ubc-biztech/bizbot-firmware/hardware/pcb-export/Untitled.kicad_pcb

## KiCad design hardware/pcb-export/Untitled.kicad_pcb (2026-11-02)

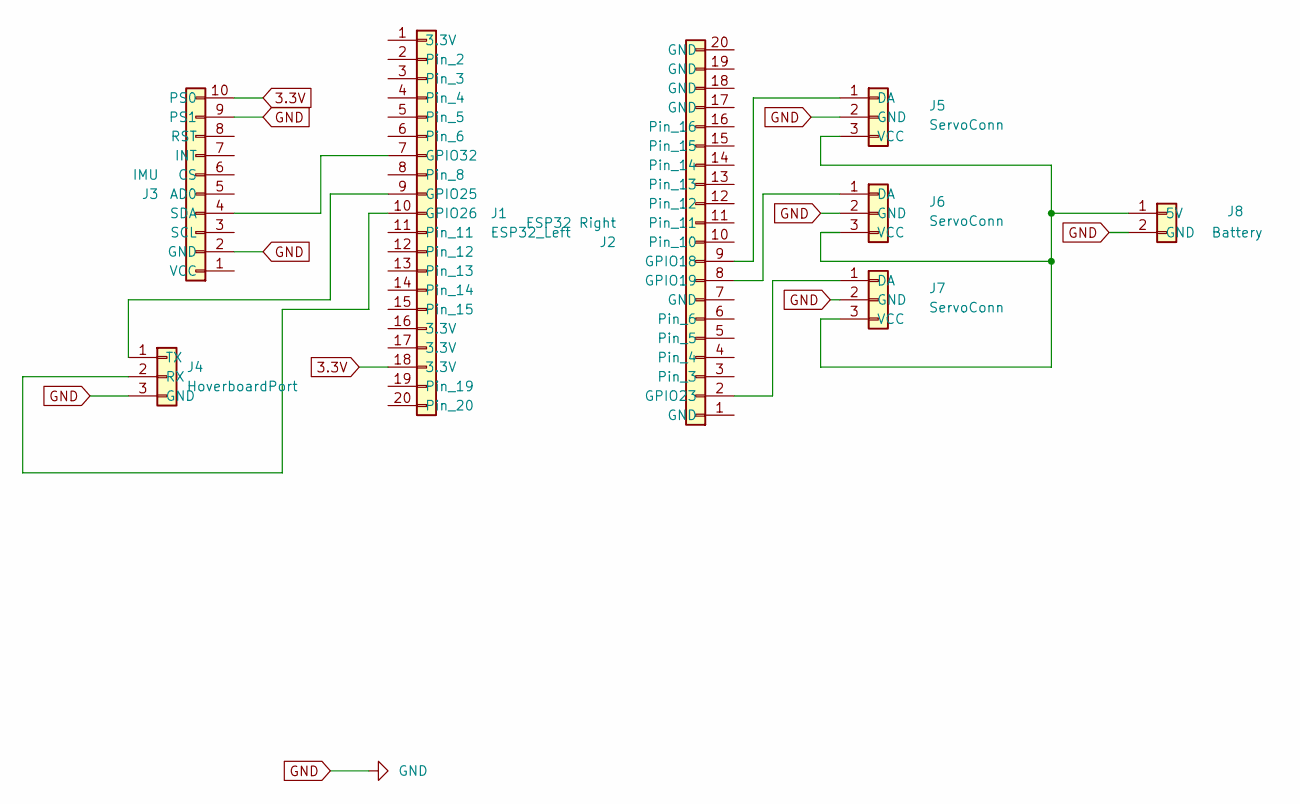
[picture p1: schematic Untitled.kicad_sch]

Parts:
J1: ESP32_Left; PinHeader_1x20_P2.54mm_Vertical
J2: ESP32 Right; PinHeader_1x20_P2.54mm_Vertical
J3: IMU; PinHeader_1x10_P2.54mm_Vertical
J4: HoverboardPort; PinHeader_1x03_P2.54mm_Vertical
J5, J6, J7: ServoConn; PinHeader_1x03_P2.54mm_Vertical
J8: Battery; PinHeader_1x02_P2.54mm_Vertical

Connections:
3.3V: J1.18 (3.3V), J3.10 (PS0)
GND: J3.2 (GND), J3.9 (PS1), J4.3 (GND), J5.2 (GND), J6.2 (GND), J7.2 (GND), J8.2 (GND)
unnamed: J1.9 (GPIO25), J4.1 (TX)
unnamed: J1.10 (GPIO26), J4.2 (RX)
unnamed: J1.7 (GPIO32), J3.4 (SDA)
unnamed: J2.9 (GPIO18), J5.1 (DA)
unnamed: J2.8 (GPIO19), J6.1 (DA)
unnamed: J2.2 (GPIO23), J7.1 (DA)
unnamed: J5.3 (VCC), J6.3 (VCC), J7.3 (VCC), J8.1 (5V)

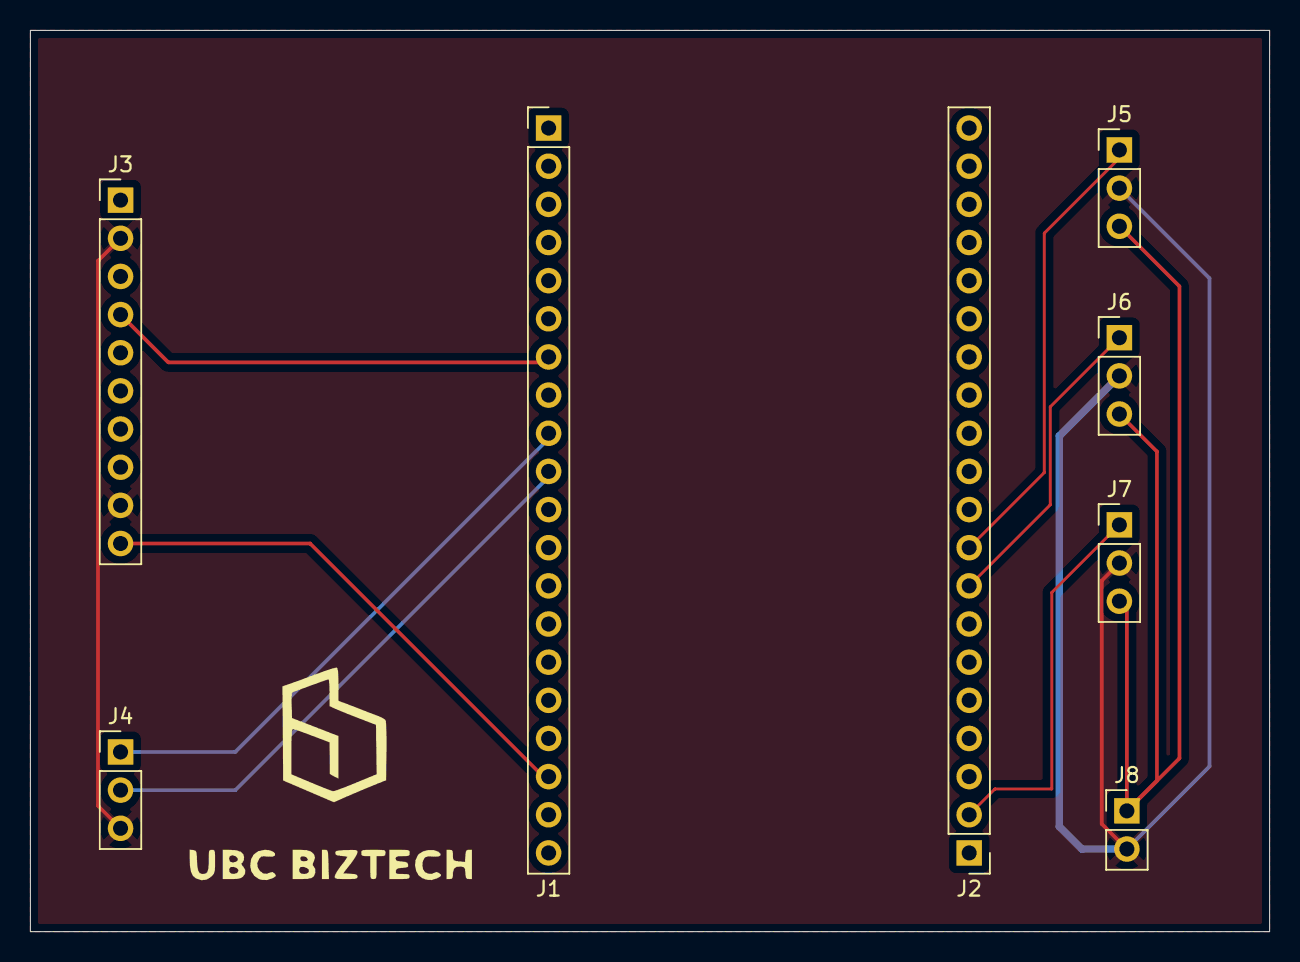
[picture p2: board Untitled.kicad_pcb from above]

Board: 2 copper layers, 82.5 x 60.0 mm, 8 parts (0 on the bottom side), 9 nets.
