ubc-biztech/bizbot-firmware/Electrical/Untitled.kicad_sch

## KiCad design Electrical/Untitled.kicad_sch (2026-10-30)

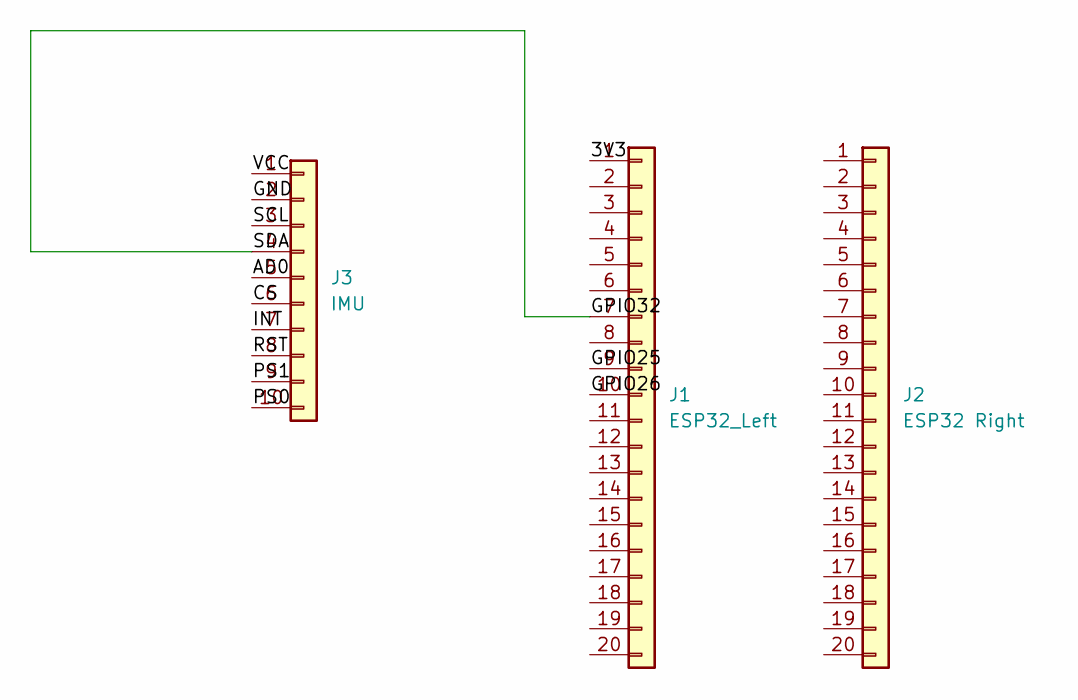
[picture p3: schematic Untitled.kicad_sch]

Parts:
J1: ESP32_Left
J2: ESP32 Right
J3: IMU

Connections:
3V3: J1.1
AD0: J3.5
CS: J3.6
GND: J3.2
GPIO25: J1.9
GPIO26: J1.10
GPIO32: J1.7, J3.4
INT: J3.7
PS0: J3.10
PS1: J3.9
RST: J3.8
SCL: J3.3
VCC: J3.1
