ubc-biztech/bizbot-firmware/Untitled/bizbotPCB.kicad_sch

## KiCad design Untitled/bizbotPCB.kicad_sch (2026-10-30)

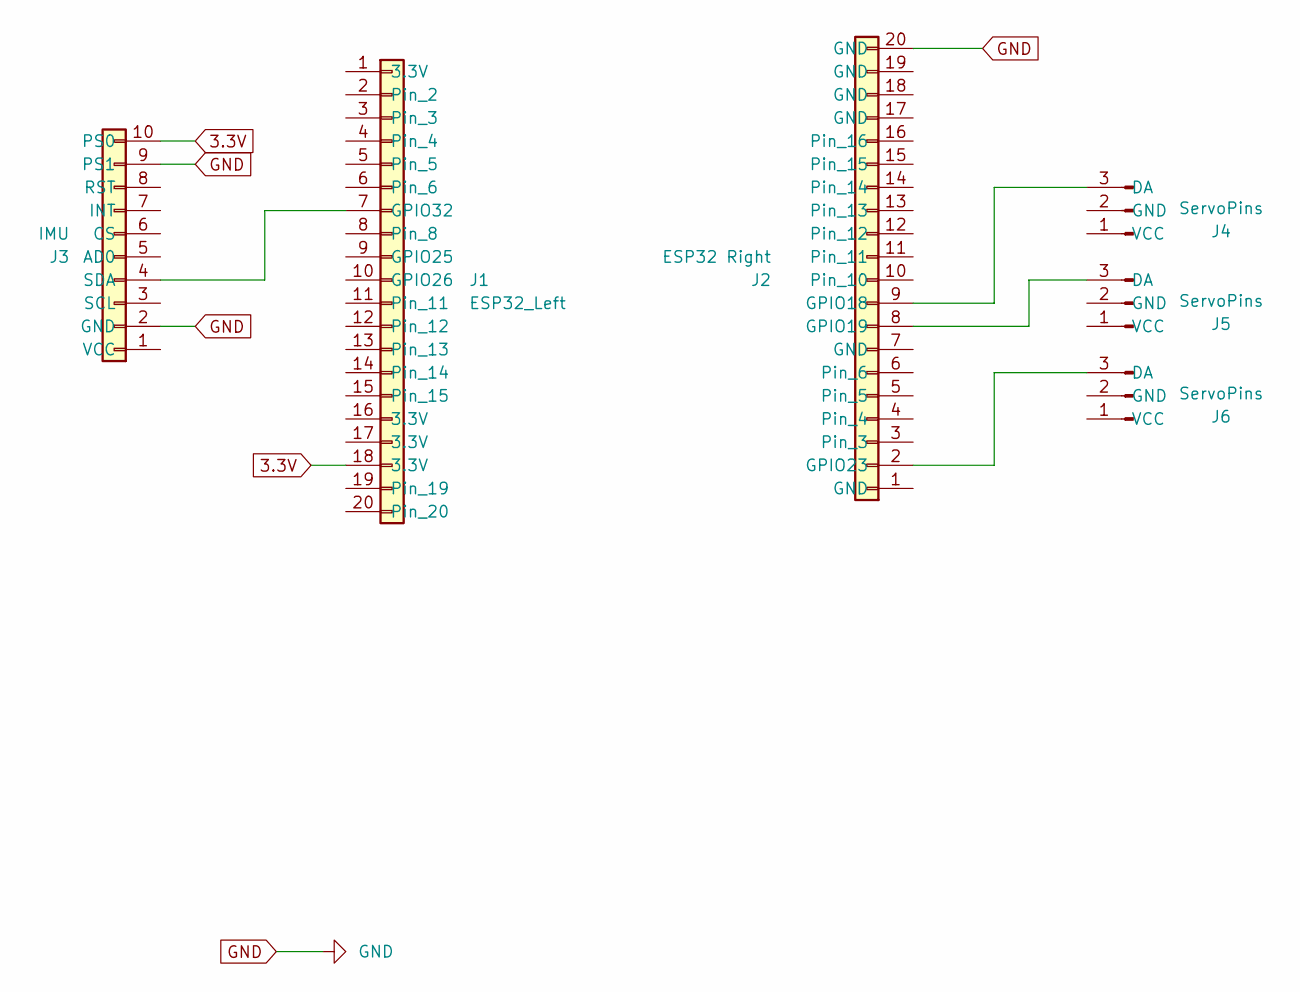
[picture p4: schematic bizbotPCB.kicad_sch]

Parts:
J1: ESP32_Left; PinHeader_1x20_P2.54mm_Vertical
J2: ESP32 Right; PinHeader_1x20_P2.54mm_Vertical
J3: IMU; PinHeader_1x10_P2.54mm_Vertical
J4, J5, J6: ServoPins

Connections:
3.3V: J1.18 (3.3V), J3.10 (PS0)
GND: J2.20 (GND), J3.2 (GND), J3.9 (PS1)
unnamed: J1.7 (GPIO32), J3.4 (SDA)
unnamed: J2.2 (GPIO23), J6.3 (DA)
unnamed: J2.8 (GPIO19), J5.3 (DA)
unnamed: J2.9 (GPIO18), J4.3 (DA)
