ubc-biztech/bizbot-firmware/firmware/src/config.h

#pragma once

#include <stdint.h>

// Hoverboard UART (EFeru hoverboard-firmware-hack-FOC, VARIANT_USART on USART3)
constexpr uint32_t HOVER_SERIAL_BAUD = 115200;
constexpr uint16_t START_FRAME = 0xABCD;
constexpr int HOVER_RX_PIN = 25;
constexpr int HOVER_TX_PIN = 26;

// Servo signal outputs (50 Hz PWM). Calibrate pulse limits for your model.
// Power servos from a separate supply rated for the servos, with common GND.
constexpr int SERVO_1_PIN = 18;
constexpr int SERVO_2_PIN = 19;
constexpr int SERVO_3_PIN = 23;
constexpr int SERVO_MIN_PULSE_US = 1000;
constexpr int SERVO_MAX_PULSE_US = 2000;

// Local Wi-Fi control. Change the password before using the robot in public.
constexpr char WIFI_AP_SSID[] = "BizBot-Control";
constexpr char WIFI_AP_PASSWORD[] = "bizbot-control";
constexpr uint16_t WIFI_CONTROL_PORT = 3333;

// Scale normalized commands into the EFeru command range (±1000).
// Balance is capped at 0.55 * 500 = ±275; steering is scaled separately.
// Command magnitude is not a percentage of motor power.
constexpr int16_t MAX_HOVERBOARD_COMMAND = 500;

// Control loop timing
constexpr uint32_t CONTROL_PERIOD_US = 5000;
constexpr float CONTROL_DT_SECONDS = 0.005f;

// Balance PID placeholders — tune on the physical robot with restrained output.
constexpr float BALANCE_KP = 0.04f;
constexpr float BALANCE_KI = 0.0f;
constexpr float BALANCE_KD = 0.001f;

// Smooth extra P authority near upright: kp * boost * tanh(error / width).
// Multiplies the near-zero P slope by 2.3; extra output caps at kp * 0.65.
constexpr float BALANCE_P_BOOST_DEG = 0.65f;
constexpr float BALANCE_P_BOOST_WIDTH_DEG = 0.5f;

// D gain grows smoothly with absolute angle error. Boost 0 disables it.
constexpr float BALANCE_D_BOOST = 0.0f;
constexpr float BALANCE_D_WIDTH_DEG = 5.0f;

// Map PID correction to the installed motors' forward/backward direction.
constexpr float BALANCE_MOTOR_SIGN = 1.0f;

// Balance controller output limits (normalized [-1, 1])
constexpr float MAX_LEAN_DEG = 5.0f;
constexpr float MAX_BALANCE_OUTPUT = 0.55f;
constexpr float MAX_TURN_OUTPUT = 0.15f;

// Outer wheel-velocity loop: mean wheel RPM -> target pitch (deg).
//   target_pitch = VEL_SIGN * (kp * v_err + ki * integral(v_err)), v_err = v_target - v_measured
// Both gains default to 0, which leaves the angle-only behaviour of main
// untouched. Tune live with SET_VEL <kp> <ki>. Physics says "moving forward
// -> lean back", so VEL_SIGN should end up such that a positive measured
// velocity lowers the target pitch; flip VEL_SIGN via SET_VEL_SIGN if the
// robot runs away instead of stopping.
constexpr float VEL_KP = 0.0f;
constexpr float VEL_KI = 0.0f;
constexpr float VEL_SIGN = -1.0f;
// Right wheel RPM feedback is mirrored (MOTOR_TEST 80 reads L +25, R -31).
constexpr float WHEEL_RIGHT_SIGN = -1.0f;
// Wheel RPM commanded by CMD_VEL linear=1.0 when the velocity loop is active.
constexpr float MAX_WHEEL_RPM = 60.0f;
constexpr float WHEEL_DIAMETER_MM = 160.0f;
// The outer loop may never ask for more lean than this.
constexpr float MAX_VEL_LEAN_DEG = 3.0f;
// Stale feedback clears velocity I and slews the target back to neutral.
constexpr unsigned long WHEEL_FEEDBACK_STALE_MS = 200;
constexpr float WHEEL_STALE_RETURN_DEG_PER_SEC = 3.0f;

// Laptop keepalive should be faster than this (keyboard_controls.py uses 200 ms).
constexpr unsigned long COMMAND_TIMEOUT_MS = 500;
constexpr float MAX_TILT_DEG = 35.0f;

// ---------------------------------------------------------------------------
// IMU: GY-BM008X = Bosch/CEVA BNO085 (BNO08x family), UART-RVC mode.
// The BNO085 does sensor fusion onboard. In UART-RVC mode it streams a fixed
// 19-byte packet (pitch/roll/yaw in degrees + accel) at ~100 Hz over one wire.
//
// UART is used because the BNO08x's I2C violates the I2C spec and wedges the
// ESP32 I2C peripheral. UART-RVC is the simplest reliable path on ESP32.
//
// Wiring (UART-RVC mode — note PS pins differ from I2C/SPI):
//   Module VCC     -> ESP32 3V3     Module GND -> ESP32 GND
//   Module SDA     -> IMU_UART_RX_PIN  (RVC data-out -> ESP32 RX; one-way stream)
//   Module PS1     -> GND           (selects UART-RVC)
//   Module PS0     -> 3V3           (selects UART-RVC)
// The hoverboard already owns UART2 (Serial2); the IMU uses UART1 (Serial1).
// ---------------------------------------------------------------------------
constexpr int IMU_UART_RX_PIN = 32;        // sensor SDA (data-out) -> ESP32 RX (UART1)
constexpr uint32_t IMU_UART_BAUD = 115200; // fixed by UART-RVC mode

// begin() waits this long for the first valid RVC packet before declaring the
// IMU absent (RVC is one-way, so this is our only presence check).
constexpr unsigned long IMU_UART_DETECT_MS = 500;

// No RVC packet within this window => IMU fault (latched stop in main.cpp).
constexpr unsigned long IMU_STALE_TIMEOUT_MS = 100;

// --- Mounting orientation --------------------------------------------------
// RVC reports roll/pitch/yaw directly (degrees); pick the axis that tracks the
// robot leaning forward/back over its wheel axle.
//
// Bench calibration: build with IMU_DEBUG_EULER=1, tip the robot FORWARD, and
// watch the serial dump. Set IMU_PITCH_SOURCE to the Euler angle that changes,
// and IMU_PITCH_SIGN so forward lean gives a POSITIVE pitchDeg.
#define IMU_PITCH_FROM_ROLL  0
#define IMU_PITCH_FROM_PITCH 1
#define IMU_PITCH_FROM_YAW   2
constexpr int   IMU_PITCH_SOURCE = IMU_PITCH_FROM_PITCH;
constexpr float IMU_PITCH_SIGN   = -1.0f;

// The pitch the IMU reports when the robot is at its TRUE balance point
// (center of mass over the axle). The controller balances around this value
// instead of 0. Tune live with SET_TRIM: hold the robot at balance, read
// pitch= from GET_STATE, and add that reading to the current trim.
constexpr float PITCH_TRIM_DEG = 2.34f;

// UART-RVC gives no gyro, so pitch rate is derived by differentiating pitch and
// low-pass filtering. Alpha in (0,1]: higher = more responsive/noisier, lower =
// smoother/laggier. Rate inherits IMU_PITCH_SIGN via pitchDeg, so no rate sign.
constexpr float IMU_RATE_LPF_ALPHA = 0.30f;

// Side-mounted RVC module: sensor Y is fore/aft, gravity is near +X at rest.
// Verify stationary tilted readings and forward sign after remounting.
constexpr float IMU_FORWARD_ACCEL_SIGN = 1.0f;
constexpr float IMU_ACCEL_FILTER_SECONDS = 0.10f;
// Normalized motor correction per m/s^2. Enable live with SET_ACCEL after
// verifying mounting; zero preserves the existing balance controller.
constexpr float ACCEL_GAIN = 0.0f;
constexpr float MAX_ACCEL_GAIN = 0.1f;
constexpr float MAX_ACCEL_OUTPUT = 0.03f;
constexpr float FORWARD_MOTOR_SIGN = 1.0f;

// Set to 1 to periodically print roll/pitch/yaw + derived rate for the
// orientation calibration above. Leave at 0 for normal operation.
#ifndef IMU_DEBUG_EULER
#define IMU_DEBUG_EULER 0
#endif

// Set to 1 to sample raw bytes off the IMU UART pin at boot and print them as
// hex (a diagnostic to see whether the sensor is transmitting at all). The RVC
// framing byte is 0xAA — a valid stream shows repeating "AA AA ...". Leave 0.
#ifndef IMU_UART_RAW_DUMP
#define IMU_UART_RAW_DUMP 0
#endif

// Set to 1 to compile without a physical IMU (pitch stays at 0; bench use only).
#ifndef IMU_USE_STUB
#define IMU_USE_STUB 0
#endif

// Set to 1 to print the balance PID internals (pitch, target, P/I/D terms,
// output, motor command) on USB serial while enabled — for gain tuning.
#ifndef PID_DEBUG
#define PID_DEBUG 0
#endif

// Set to 1 to bypass ALL control logic and safety gates and spin both wheels
// slowly at a constant command — a hoverboard UART link test. The wheels turn
// as soon as the board powers up, with no ENABLE, no keepalive, and no tilt
// cutoff. WHEELS OFF THE GROUND. Leave 0 for normal operation.
#ifndef MOTOR_TEST
#define MOTOR_TEST 0
#endif

// Constant speed command sent while MOTOR_TEST=1 (EFeru range is -1000..1000;
// wheels typically start turning around 25-50).
constexpr int16_t MOTOR_TEST_SPEED = 200;
