ubc-biztech/bizbot-firmware/firmware/src/control/PID.h

#pragma once

class PID {
public:
    PID(float kp, float ki, float kd);

    float update(
        float target,
        float measurement,
        float dtSeconds,
        float measurementRate = 0.0f
    );

    void setTunings(float kp, float ki, float kd);
    void setOutputLimits(float minOutput, float maxOutput);
    void setProportionalBoost(float errorBoost, float errorWidth);
    void setDirectionalP(float front, float back);
    void setDerivativeBoost(float boost, float width);
    void reset();

    // Last computed terms (pre-clamp), for tuning diagnostics.
    float lastPTerm() const { return lastP; }
    float lastITerm() const { return lastI; }
    float lastDTerm() const { return lastD; }

private:
    float lastP = 0.0f;
    float lastI = 0.0f;
    float lastD = 0.0f;

    float kp;
    float kpBack;
    float ki;
    float kd;

    float integral = 0.0f;
    float proportionalBoost = 0.0f;
    float proportionalWidth = 1.0f;
    float derivativeBoost = 0.0f;
    float derivativeWidth = 5.0f;

    float minOutput = -1.0f;
    float maxOutput = 1.0f;
    bool hasOutputLimits = false;
};
