ubc-biztech/bizbot-firmware/firmware/src/comms/CommandParser.cpp

#include "CommandParser.h"
#include "../config.h"
#include "../hal/ServoControl.h"
#include "../hal/OffsetStorage.h"
#include <math.h>

namespace {
constexpr float MIN_COMMAND_VALUE = -1.0f;
constexpr float MAX_COMMAND_VALUE = 1.0f;
}

void CommandParser::update(
    Stream& input,
    Print& output,
    RobotState& state
) {
    while (input.available() > 0) {
        const char character = static_cast<char>(input.read());

        if (character == '\r') {
            continue;
        }

        if (character == '\n') {
            if (discardingLine) {
                discardingLine = false;
                bufferLength = 0;
                output.println("ERR COMMAND_TOO_LONG");
                continue;
            }

            buffer[bufferLength] = '\0';

            if (bufferLength > 0) {
                handleCommand(buffer, output, state);
            }

            bufferLength = 0;
            continue;
        }

        if (discardingLine) {
            continue;
        }

        // Keep one byte available for the terminating '\0'.
        if (bufferLength >= MAX_COMMAND_LENGTH - 1) {
            discardingLine = true;
            bufferLength = 0;
            continue;
        }

        buffer[bufferLength] = character;
        bufferLength++;
    }
}

void CommandParser::handleCommand(
    const char* command,
    Print& output,
    RobotState& state
) {
    if (handleServoCommand(command, output)) return;

    if (strcmp(command, "ENABLE") == 0) {
        state.enabled = true;
        state.lastCommandMs = millis();
        output.println("OK ENABLED");
        return;
    }

    if (strcmp(command, "DISABLE") == 0) {
        state.enabled = false;
        state.velIntegral = 0.0f;
        state.targetPitchDeg = 0.0f;
        state.targetLinear = 0.0f;
        state.targetAngular = 0.0f;
        output.println("OK DISABLED");
        return;
    }

    if (strcmp(command, "STOP") == 0) {
        state.targetLinear = 0.0f;
        state.targetAngular = 0.0f;
        state.lastCommandMs = millis();
        output.println("OK STOP");
        return;
    }

    if (strncmp(command, "CMD_VEL ", 8) == 0) {
        handleVelocityCommand(command, output, state);
        return;
    }

    if (strncmp(command, "SET_PID_FB ", 11) == 0) {
        float front, back, ki, kd;
        char extra = '\0';
        if (sscanf(command, "SET_PID_FB %f %f %f %f %c", &front, &back, &ki, &kd, &extra) != 4) {
            output.println("ERR INVALID_ARGUMENTS");
            return;
        }
        if (!isfinite(front) || !isfinite(back) || !isfinite(ki) || !isfinite(kd) ||
            front < 0 || front > 5 || back < 0 || back > 5 ||
            ki < 0 || ki > 5 || kd < 0 || kd > 5) {
            output.println("ERR OUT_OF_RANGE");
            return;
        }
        state.balanceKp = front;
        state.balanceKpBack = back;
        state.balanceKi = ki;
        state.balanceKd = kd;
        state.resetBalanceRequested = true;
        state.lastCommandMs = millis();
        output.println("OK SET_PID_FB");
        return;
    }

    if (strncmp(command, "SET_PID ", 8) == 0) {
        handlePidCommand(command, output, state);
        return;
    }

    if (strncmp(command, "SET_D_BOOST ", 12) == 0) {
        float boost, width;
        char extra = '\0';
        if (sscanf(command, "SET_D_BOOST %f %f %c", &boost, &width, &extra) != 2) {
            output.println("ERR INVALID_ARGUMENTS");
            return;
        }
        if (!isfinite(boost) || !isfinite(width) || boost < 0.0f || boost > 4.0f ||
            width < 0.1f || width > 35.0f) {
            output.println("ERR OUT_OF_RANGE");
            return;
        }
        state.balanceDBoost = boost;
        state.balanceDWidth = width;
        state.lastCommandMs = millis();
        output.println("OK SET_D_BOOST");
        return;
    }

    if (strncmp(command, "SET_P_WIDTH ", 12) == 0) {
        float width = 0.0f;
        char extra = '\0';
        if (sscanf(command, "SET_P_WIDTH %f %c", &width, &extra) != 1) {
            output.println("ERR INVALID_ARGUMENTS");
            return;
        }
        if (!isfinite(width) || width < 0.1f || width > 5.0f) {
            output.println("ERR OUT_OF_RANGE");
            return;
        }
        state.balancePBoostWidth = width;
        state.lastCommandMs = millis();
        output.println("OK SET_P_WIDTH");
        return;
    }

    if (strncmp(command, "SET_P_BOOST ", 12) == 0) {
        float boost = 0.0f;
        char extra = '\0';
        if (sscanf(command, "SET_P_BOOST %f %c", &boost, &extra) != 1) {
            output.println("ERR INVALID_ARGUMENTS");
            return;
        }
        if (!isfinite(boost) || boost < 0.0f || boost > 2.0f) {
            output.println("ERR OUT_OF_RANGE");
            return;
        }
        state.balancePBoost = boost;
        state.lastCommandMs = millis();
        output.println("OK SET_P_BOOST");
        return;
    }

    if (strncmp(command, "SET_ACCEL ", 10) == 0) {
        float gain = 0.0f;
        char extra = '\0';
        if (sscanf(command, "SET_ACCEL %f %c", &gain, &extra) != 1) {
            output.println("ERR INVALID_ARGUMENTS");
            return;
        }
        if (!isfinite(gain) || gain < 0.0f || gain > MAX_ACCEL_GAIN) {
            output.println("ERR OUT_OF_RANGE");
            return;
        }
        if (gain > 0.0f && (state.lastImuUpdateMs == 0 ||
            millis() - state.lastImuUpdateMs > IMU_STALE_TIMEOUT_MS ||
            !isfinite(state.forwardAccel) || fabsf(state.forwardAccel) > 0.5f)) {
            output.println("ERR ACCEL_NOT_NEUTRAL");
            return;
        }
        state.accelGain = gain;
        state.resetBalanceRequested = true;
        state.lastCommandMs = millis();
        output.print("OK SET_ACCEL ka=");
        output.println(gain, 3);
        return;
    }

    if (strcmp(command, "ZERO_IMU") == 0) {
        if (state.lastImuUpdateMs == 0 ||
            millis() - state.lastImuUpdateMs > IMU_STALE_TIMEOUT_MS) {
            output.println("ERR IMU_STALE");
            return;
        }
        const float trim = state.pitchTrimDeg + state.pitchDeg;
        if (!isfinite(trim) || fabsf(trim) > 15.0f) {
            output.println("ERR OUT_OF_RANGE");
            return;
        }
        if (!isfinite(state.pitchRateDegPerSec) ||
            fabsf(state.pitchRateDegPerSec) > 5.0f) {
            output.println("ERR IMU_MOVING");
            return;
        }
        if (!savePitchOffset(trim)) {
            output.println("ERR OFFSET_SAVE_FAILED");
            return;
        }
        state.pitchTrimDeg = trim;
        state.pitchDeg = 0.0f;
        state.targetLinear = 0.0f;
        state.targetAngular = 0.0f;
        state.resetBalanceRequested = true;
        state.lastCommandMs = millis();
        output.print("OK ZERO_IMU trim=");
        output.println(trim, 2);
        return;
    }

    if (strncmp(command, "SET_TRIM ", 9) == 0) {
        handleTrimCommand(command, output, state);
        return;
    }

    if (strncmp(command, "SET_FUSION ", 11) == 0) {
        float diameter, tau;
        char extra = '\0';
        if (sscanf(command, "SET_FUSION %f %f %c", &diameter, &tau, &extra) != 2) {
            output.println("ERR INVALID_ARGUMENTS");
            return;
        }
        if (!isfinite(diameter) || !isfinite(tau) ||
            (diameter != 0 && (diameter < 50 || diameter > 500)) || tau < 0 || tau > 1) {
            output.println("ERR OUT_OF_RANGE");
            return;
        }
        state.wheelDiameterMm = diameter;
        state.velocityFusionTau = tau;
        state.resetBalanceRequested = true;
        state.lastCommandMs = millis();
        output.println("OK SET_FUSION");
        return;
    }

    if (strncmp(command, "SET_VEL ", 8) == 0) {
        float kp = 0.0f, ki = 0.0f;
        char extra = '\0';
        if (sscanf(command, "SET_VEL %f %f %c", &kp, &ki, &extra) != 2) {
            output.println("ERR INVALID_ARGUMENTS");
            return;
        }
        // deg per RPM; 1.0 would be 60 deg at 60 RPM, far past sane.
        if (!isfinite(kp) || !isfinite(ki) || kp < 0.0f || kp > 1.0f ||
            ki < 0.0f || ki > 1.0f) {
            output.println("ERR OUT_OF_RANGE");
            return;
        }
        state.velKp = kp;
        state.velKi = ki;
        state.velIntegral = 0.0f;
        state.lastCommandMs = millis();
        output.println("OK SET_VEL");
        return;
    }

    if (strncmp(command, "SET_VEL_SIGN ", 13) == 0) {
        float sign = 0.0f;
        char extra = '\0';
        if (sscanf(command, "SET_VEL_SIGN %f %c", &sign, &extra) != 1 ||
            (sign != 1.0f && sign != -1.0f)) {
            output.println("ERR INVALID_ARGUMENTS");
            return;
        }
        state.velSign = sign;
        state.velIntegral = 0.0f;
        state.lastCommandMs = millis();
        output.println("OK SET_VEL_SIGN");
        return;
    }

    if (strcmp(command, "GET_STATE") == 0) {
        state.lastCommandMs = millis();
        printState(output, state);
        return;
    }

    output.println("ERR UNKNOWN_COMMAND");
}

void CommandParser::handleVelocityCommand(
    const char* command,
    Print& output,
    RobotState& state
) {
    if (!state.enabled) {
        output.println("ERR DISABLED");
        return;
    }

    float linear = 0.0f;
    float angular = 0.0f;
    char extra = '\0';

    const int parsed = sscanf(
        command,
        "CMD_VEL %f %f %c",
        &linear,
        &angular,
        &extra
    );

    if (parsed != 2) {
        output.println("ERR INVALID_ARGUMENTS");
        return;
    }

    const bool linearOutOfRange =
        linear < MIN_COMMAND_VALUE || linear > MAX_COMMAND_VALUE;
    const bool angularOutOfRange =
        angular < MIN_COMMAND_VALUE || angular > MAX_COMMAND_VALUE;

    if (linearOutOfRange || angularOutOfRange) {
        output.println("ERR OUT_OF_RANGE");
        return;
    }

    state.targetLinear = linear;
    state.targetAngular = angular;
    state.lastCommandMs = millis();
    output.println("OK CMD_VEL");
}

void CommandParser::handlePidCommand(
    const char* command,
    Print& output,
    RobotState& state
) {
    float kp = 0.0f;
    float ki = 0.0f;
    float kd = 0.0f;
    char extra = '\0';

    const int parsed = sscanf(
        command,
        "SET_PID %f %f %f %c",
        &kp,
        &ki,
        &kd,
        &extra
    );

    if (parsed != 3) {
        output.println("ERR INVALID_ARGUMENTS");
        return;
    }

    // Generous sanity bounds; kp=5 already means full output at 0.2 deg error.
    const bool outOfRange =
        !isfinite(kp) || !isfinite(ki) || !isfinite(kd) ||
        kp < 0.0f || kp > 5.0f ||
        ki < 0.0f || ki > 5.0f ||
        kd < 0.0f || kd > 5.0f;

    if (outOfRange) {
        output.println("ERR OUT_OF_RANGE");
        return;
    }

    state.balanceKp = kp;
    state.balanceKpBack = kp;
    state.balanceKi = ki;
    state.balanceKd = kd;
    state.lastCommandMs = millis();
    output.println("OK SET_PID");
}

void CommandParser::handleTrimCommand(
    const char* command,
    Print& output,
    RobotState& state
) {
    float trim = 0.0f;
    char extra = '\0';

    const int parsed = sscanf(command, "SET_TRIM %f %c", &trim, &extra);

    if (parsed != 1) {
        output.println("ERR INVALID_ARGUMENTS");
        return;
    }

    // A balance point more than 15 deg off vertical means something is wrong.
    if (!isfinite(trim) || trim < -15.0f || trim > 15.0f) {
        output.println("ERR OUT_OF_RANGE");
        return;
    }

    if (!savePitchOffset(trim)) {
        output.println("ERR OFFSET_SAVE_FAILED");
        return;
    }
    state.pitchDeg += state.pitchTrimDeg - trim;
    state.pitchTrimDeg = trim;
    state.resetBalanceRequested = true;
    state.lastCommandMs = millis();
    output.print("OK SET_TRIM trim=");
    output.println(trim, 2);
}

void CommandParser::printState(
    Print& output,
    const RobotState& state
) {
    output.print("STATE enabled=");
    output.print(state.enabled ? 1 : 0);
    output.print(" linear=");
    output.print(state.targetLinear, 3);
    output.print(" angular=");
    output.print(state.targetAngular, 3);
    output.print(" kp=");
    output.print(state.balanceKp, 4);
    output.print(" kp_front=");
    output.print(state.balanceKp, 4);
    output.print(" kp_back=");
    output.print(state.balanceKpBack, 4);
    output.print(" ki=");
    output.print(state.balanceKi, 4);
    output.print(" kd=");
    output.print(state.balanceKd, 4);
    output.print(" dboost=");
    output.print(state.balanceDBoost, 3);
    output.print(" dwidth=");
    output.print(state.balanceDWidth, 3);
    output.print(" pboost=");
    output.print(state.balancePBoost, 3);
    output.print(" pwidth=");
    output.print(state.balancePBoostWidth, 3);
    output.print(" trim=");
    output.print(state.pitchTrimDeg, 2);
    output.print(" pitch=");
    output.print(state.pitchDeg, 2);
    output.print(" pitch_rate=");
    output.print(state.pitchRateDegPerSec, 2);
    output.print(" accel=");
    output.print(state.forwardAccel, 3);
    output.print(" ka=");
    output.print(state.accelGain, 3);
    output.print(" acorr=");
    output.print(state.accelCorrection, 3);
    output.print(" ax="); output.print(state.rawAccelX, 3);
    output.print(" ay="); output.print(state.rawAccelY, 3);
    output.print(" az="); output.print(state.rawAccelZ, 3);
    output.print(" raw_roll="); output.print(state.rawRoll, 2);
    output.print(" raw_pitch="); output.print(state.rawPitch, 2);
    output.print(" battery=");
    output.print(state.batteryVoltage, 2);
    output.print(" wheel_l=");
    output.print(state.leftWheelSpeed, 0);
    output.print(" wheel_r=");
    output.print(state.rightWheelSpeed, 0);
    output.print(" vkp="); output.print(state.velKp, 5);
    output.print(" vki="); output.print(state.velKi, 5);
    output.print(" vsign="); output.print(state.velSign, 0);
    output.print(" fused_velocity="); output.print(state.fusedVelocity, 2);
    output.print(" wheel_mm="); output.print(state.wheelDiameterMm, 1);
    output.print(" fusion_tau="); output.print(state.velocityFusionTau, 2);
    output.print(" velocity="); output.print(state.wheelVelocity, 1);
    output.print(" target_pitch="); output.print(state.targetPitchDeg, 3);
    output.print(" vint="); output.print(state.velIntegral, 3);
    const unsigned long age = millis() - state.lastMotorFeedbackMs;
    output.print(" wheel_age_ms=");
    if (state.lastMotorFeedbackMs == 0) output.print(-1);
    else output.print(age);
    output.print(" wheel_fresh=");
    output.println(state.lastMotorFeedbackMs != 0 && age <= WHEEL_FEEDBACK_STALE_MS ? 1 : 0);
}
