ubc-biztech/bizbot-firmware/(commit log)

2026-06-09 PlatformIO boiler plate
2026-06-09 Define global robot we will need for the PID loop. Also update readme info
2026-06-09 ESP32 wiring
2026-07-05 made basic PID controller
2026-07-05 added extra safety to PID calculations
2026-08-02 Add wireless connection via wifi.
2026-08-02 Add live IMU visualizer for the balancing robot
    Parses the IMU_DEBUG_EULER serial lines and animates a side-view of the
    robot leaning by the reported pitch, plus rolling pitch/rate charts with
    the 35-degree tilt cutoff marked. --demo runs without hardware and
    --save-frame renders one frame headlessly.
2026-08-03 IMU visualization
2026-08-03 active pid tuning
2026-09-26 add wheel velocity check
2026-09-27 Restore balance control with acceleration damping and persistent IMU offsets
2026-09-27 Add browser tuner (tools/tuner) for the main firmware, no firmware changes
    Vite page plus a TCP bridge to the robot over Wi-Fi, same protocol as
    keyboard_controls.py: ENABLE/DISABLE/STOP/GET_STATE/SET_PID/SET_TRIM/
    ZERO_IMU only. Balancing on/off switch driven by reported state, pitch
    gain buttons, trim, presets, live pitch trace with CSV export, log.
    Also fixes requirements.txt (pynput, not keyboard) and documents flashing.
2026-09-27 Tuner: bridge spawns keyboard_controls.py, drop auto push and GET_STATE poll, remove dead widgets; IMU rate LPF alpha 0.15
2026-11-01 RL policy (O 120M) drives on Daniel's firmware; fix triple policy call
    Port of the RL balance policy onto origin/daniel-updates:
    - src/control/bizbot_policy.{c,h}: O 120M export (fit_ft_O ckpt_0120M), with
    the policy code in IRAM (IRAM_ATTR) as well as the weights in DRAM.
    - src/main.cpp: the policy drives from ENABLE (PID still computed, logged);
    runs every 2nd 5 ms tick, DZ_COMP 20 on every nonzero command, one
    non-blocking "RL <ms> <pitch> <accel> <wheel> <batt> <pid> <rl> <us>" line.
    Bug fixed: Arduino's constrain() is a macro that evaluated
    bizbot_policy_tick() up to 3 times per tick, so the policy state stepped 3x
    and each run took 7.3 ms. Now called once (2.44 ms, 10 ms period,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
2026-11-01 Add MuJoCo balance sim, RL training, and exported policy
    sim/bizbot_mj: MuJoCo plant (rigid bodies, wheel-floor contact, flex, stiction)
    with randomized hoverboard, IMU and wheel-feedback models, and a balance env.
    model/mj: PPO, TD3, PBT, teacher-student distillation, evaluation against LQR
    baselines, sweeps, dashboard data, and an MuJoCo viewer (watch.py).
    model/deploy: best sensor-only policy exported to C (bizbot_policy.c/.h) with a
    runtime that builds its observation as the sim does, JSON weights, test vectors
    and SPEC.md; the host test reproduces the sim's commands.
    Also commits the earlier numpy sim (sim/bizbot_sim) and SB3 trainers (model/).
    .gitignore: training outputs (model/runs,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
2026-11-01 Sim, RL training and harness work since the MuJoCo commit
    Local working-tree changes from the tuner checkout (sim/, model/, AGENTS.md,
    sim.sh): voltage-mode/hall/hand/floor-spring sim effects, DZ_COMP and l1
    reward terms, half-precision policy export, viewer updates, new tests.
    Firmware is not taken from that checkout: firmware/ stays Daniel's firmware
    plus the RL policy (the version that balanced on 2026-11-01).
2026-11-02 Clean up the repo root
    - PCB and schematics in one place: bizbotPCB/ -> hardware/pcb/,
    Untitled/ (gerbers, drill files) -> hardware/pcb-export/,
    Electrical/ -> hardware/electrical/.
    - HANDOVER.md -> docs/, sim.sh -> tools/ (its usage line and cd already
    assumed tools/).
    - CLAUDE.md and AGENTS.md were the same rules; CLAUDE.md is now the one file
    (for Claude and Codex) and AGENTS.md links to it. Adds the rule never to put
    a side-effecting call inside an Arduino macro such as constrain() (the
    2026-11-01 triple policy call).
    - Stop tracking the two committed Python venvs (.venv-servo/,
    interaction/.venv-servo/), .vscode/ and .DS_Store files; all now ignored.
    They stay on disk lo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
2026-11-02 Send MuJoCo warnings to stderr instead of MUJOCO_LOG.TXT
    MuJoCo's default warning handler appends to MUJOCO_LOG.TXT in the working
    directory (it logged unstable-sim warnings on 10-22/10-23). The sim plant now
    installs a handler that prints "MuJoCo warning: ..." to stderr, so no log file
    is written; the stale log is deleted and its .gitignore line removed.
2026-11-02 Move servo-sweep into firmware/ and the tuner into tools/
    - standalone/servo-sweep -> firmware/servo-sweep (separate PlatformIO project;
    not part of the BizBot build, which only compiles firmware/src). README
    build commands and the restore line point at firmware/; the link in
    tools/SERVO_CONTROLLER.md is updated.
    - tuner/ -> tools/tuner/. bridge.js finds the repo root two levels up; its
    README, the AGENTS.md rule and the README tree use the new path.
2026-11-02 Path fixes for the servo-sweep and tuner moves
    servo-sweep README build/restore lines, tuner README cd line, and bridge.js
    repo root (two levels up). Missed from the move commit.
2026-11-02 Add Makefile for common commands
    make build / flash / servo-sweep / drive / tuner / sim / export / test; run
    make for the list. Variables (PORT, POLICY, ROBOT, OUT, PIO, PY) can be
    overridden on the command line.
2026-11-02 Remove old pages, the old 2D-sim trainer, stale docs and KiCad junk
    - Web pages: drop the old 2D-sim pages (sim/viewer.html + sim/live.py,
    sim/index.html). Kept: tools/tuner and the MuJoCo viewer (model/mj).
    sim/bizbot_sim stays: the viewer and trainers import its controllers.
    - Old PPO trainer for the 2D sim (model/train.py, sweep.py, vec_env.py,
    evaluate.py, requirements.txt): replaced by model/mj, imported by nothing.
    - tools/sim.sh: replaced by `make sim` (it pointed at the old I 80M policy).
    - docs/HANDOFF-2026-09-26.md, docs/HANDOVER.md: stale (pre-reorg, pre-RL).
    - hardware/: KiCad lock file, autosaves, fp-info-cache files, the duplicate
    "MyLogos.pretty copy" library and Untit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
